lhr-solar/BPS-TestPCB/3d step files/11-PIHER_3D_PT10MH01.STEP

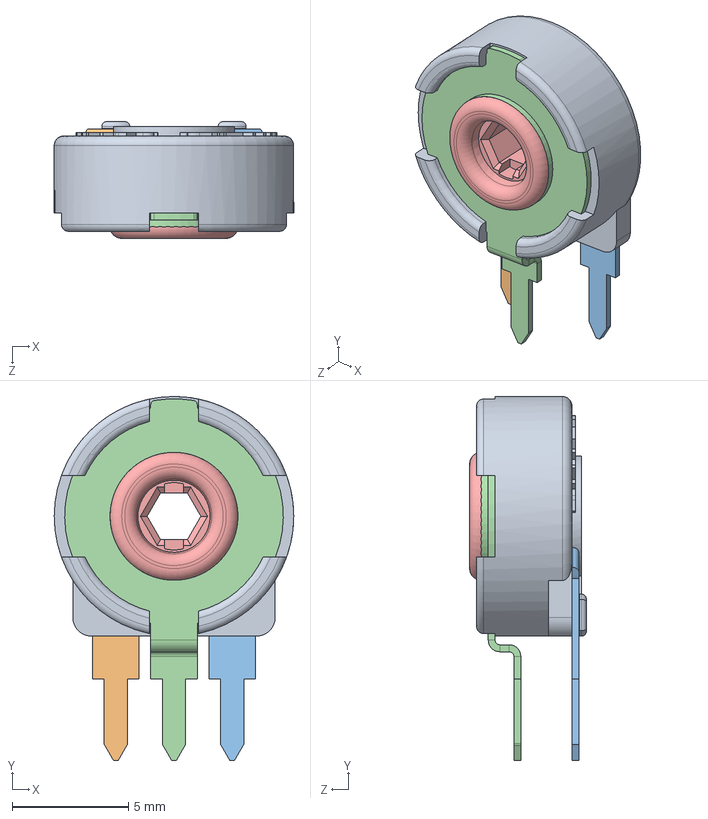
[picture p1: CAD file, 2021-10-09]
3d step files/11-PIHER_3D_PT10MH01.STEP
10.3 x 15.7 x 5.02 mm
PT10MH01-CARCASA
PT10MH01-TERMINAL DERECHO
PT10MH01-TERMINAL IZQUIERDO
PT10MH01-COLECTOR
PT10MH01-PORTACURSOR_Predeterminada
