lhr-solar/BPS-TestPCB/3d step files/10-PIHER_3D_PT10LV10.STEP

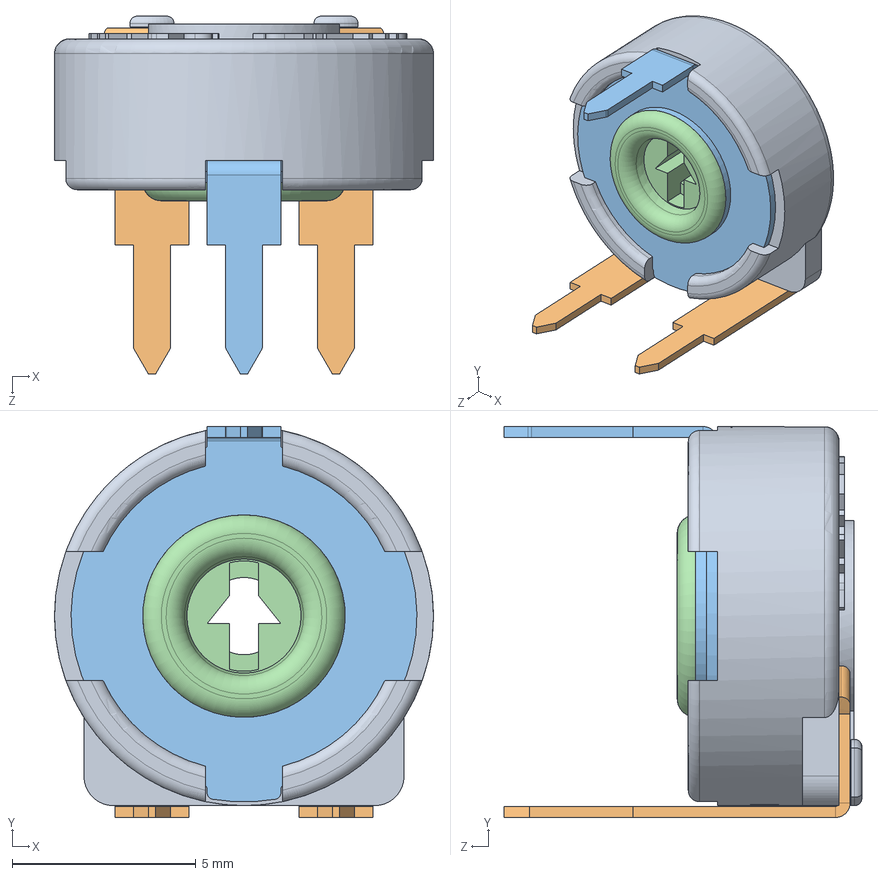
[picture p2: CAD file, 2021-10-09]
3d step files/10-PIHER_3D_PT10LV10.STEP
10.3 x 10.6 x 9.72 mm
PT10LV10-CARCASA
PT10LV10-TERMINAL DERECHO
PT10LV10-TERMINAL IZQUIERDO
PT10LV10-COLECTOR REBORDEADO
PT10LV10-PORTACURSOR_Predeterminada
