lhr-solar/BPS-TestPCB/3d step files/Banana_Receptacle.step

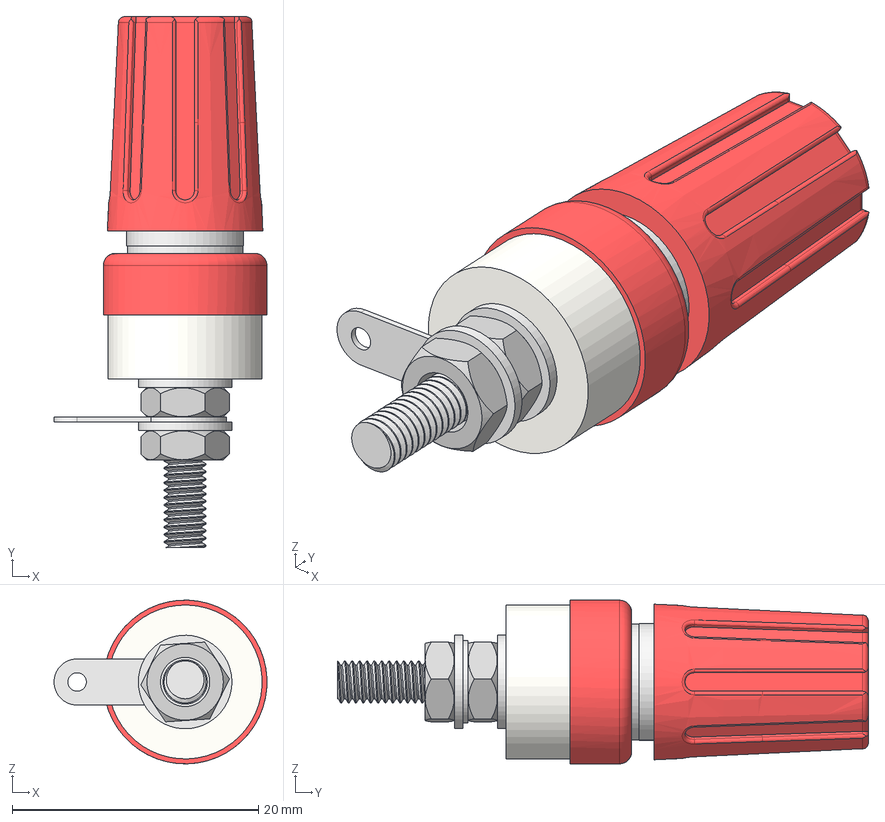
[picture p3: CAD file, 2021-10-09]
3d step files/Banana_Receptacle.step
17.3 x 43.1 x 13.3 mm
knob
external_spacer
teflon_spacer
washer x 2
nut x 2
solder_lug
knob_internal_contact
binding_post
