lhr-solar/BPS-TestPCB/3d step files/RFM-0505S_RCP.step

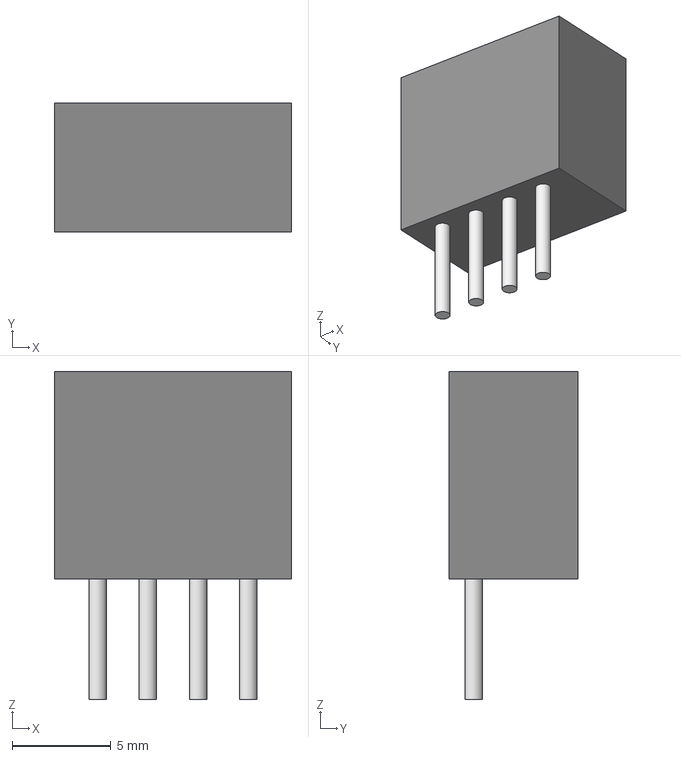
[picture p4: CAD file, 2021-10-09]
3d step files/RFM-0505S_RCP.step
12.0 x 6.50 x 16.6 mm
