lhr-solar/BPS-TestPCB/3d step files/12-PIHER_3D_PT10LH02.STEP

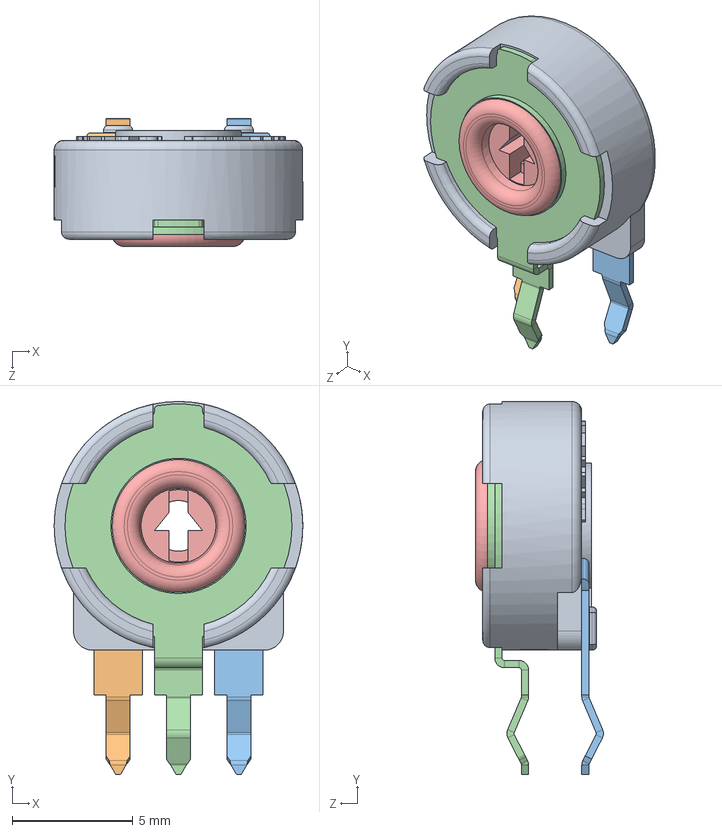
[picture p5: CAD file, 2021-10-09]
3d step files/12-PIHER_3D_PT10LH02.STEP
10.3 x 15.4 x 5.30 mm
PT10LH02-CARCASA
PT10LH02-TERMINAL DERECHO
PT10LH02-TERMINAL IZQUIERDO
PT10LH02-COLECTOR
PT10LH02-PORTACURSOR_Predeterminada
