lhr-solar/BPS-TestPCB/(list of files, cad)

Other CAD files:
3d step files/9-PIHER_3D_PT10MV10.STEP
