lhr-solar/BPS-TestPCB/BPS-Test.kicad_pcb

## KiCad design BPS-Test.kicad_pcb (2021-10-16)

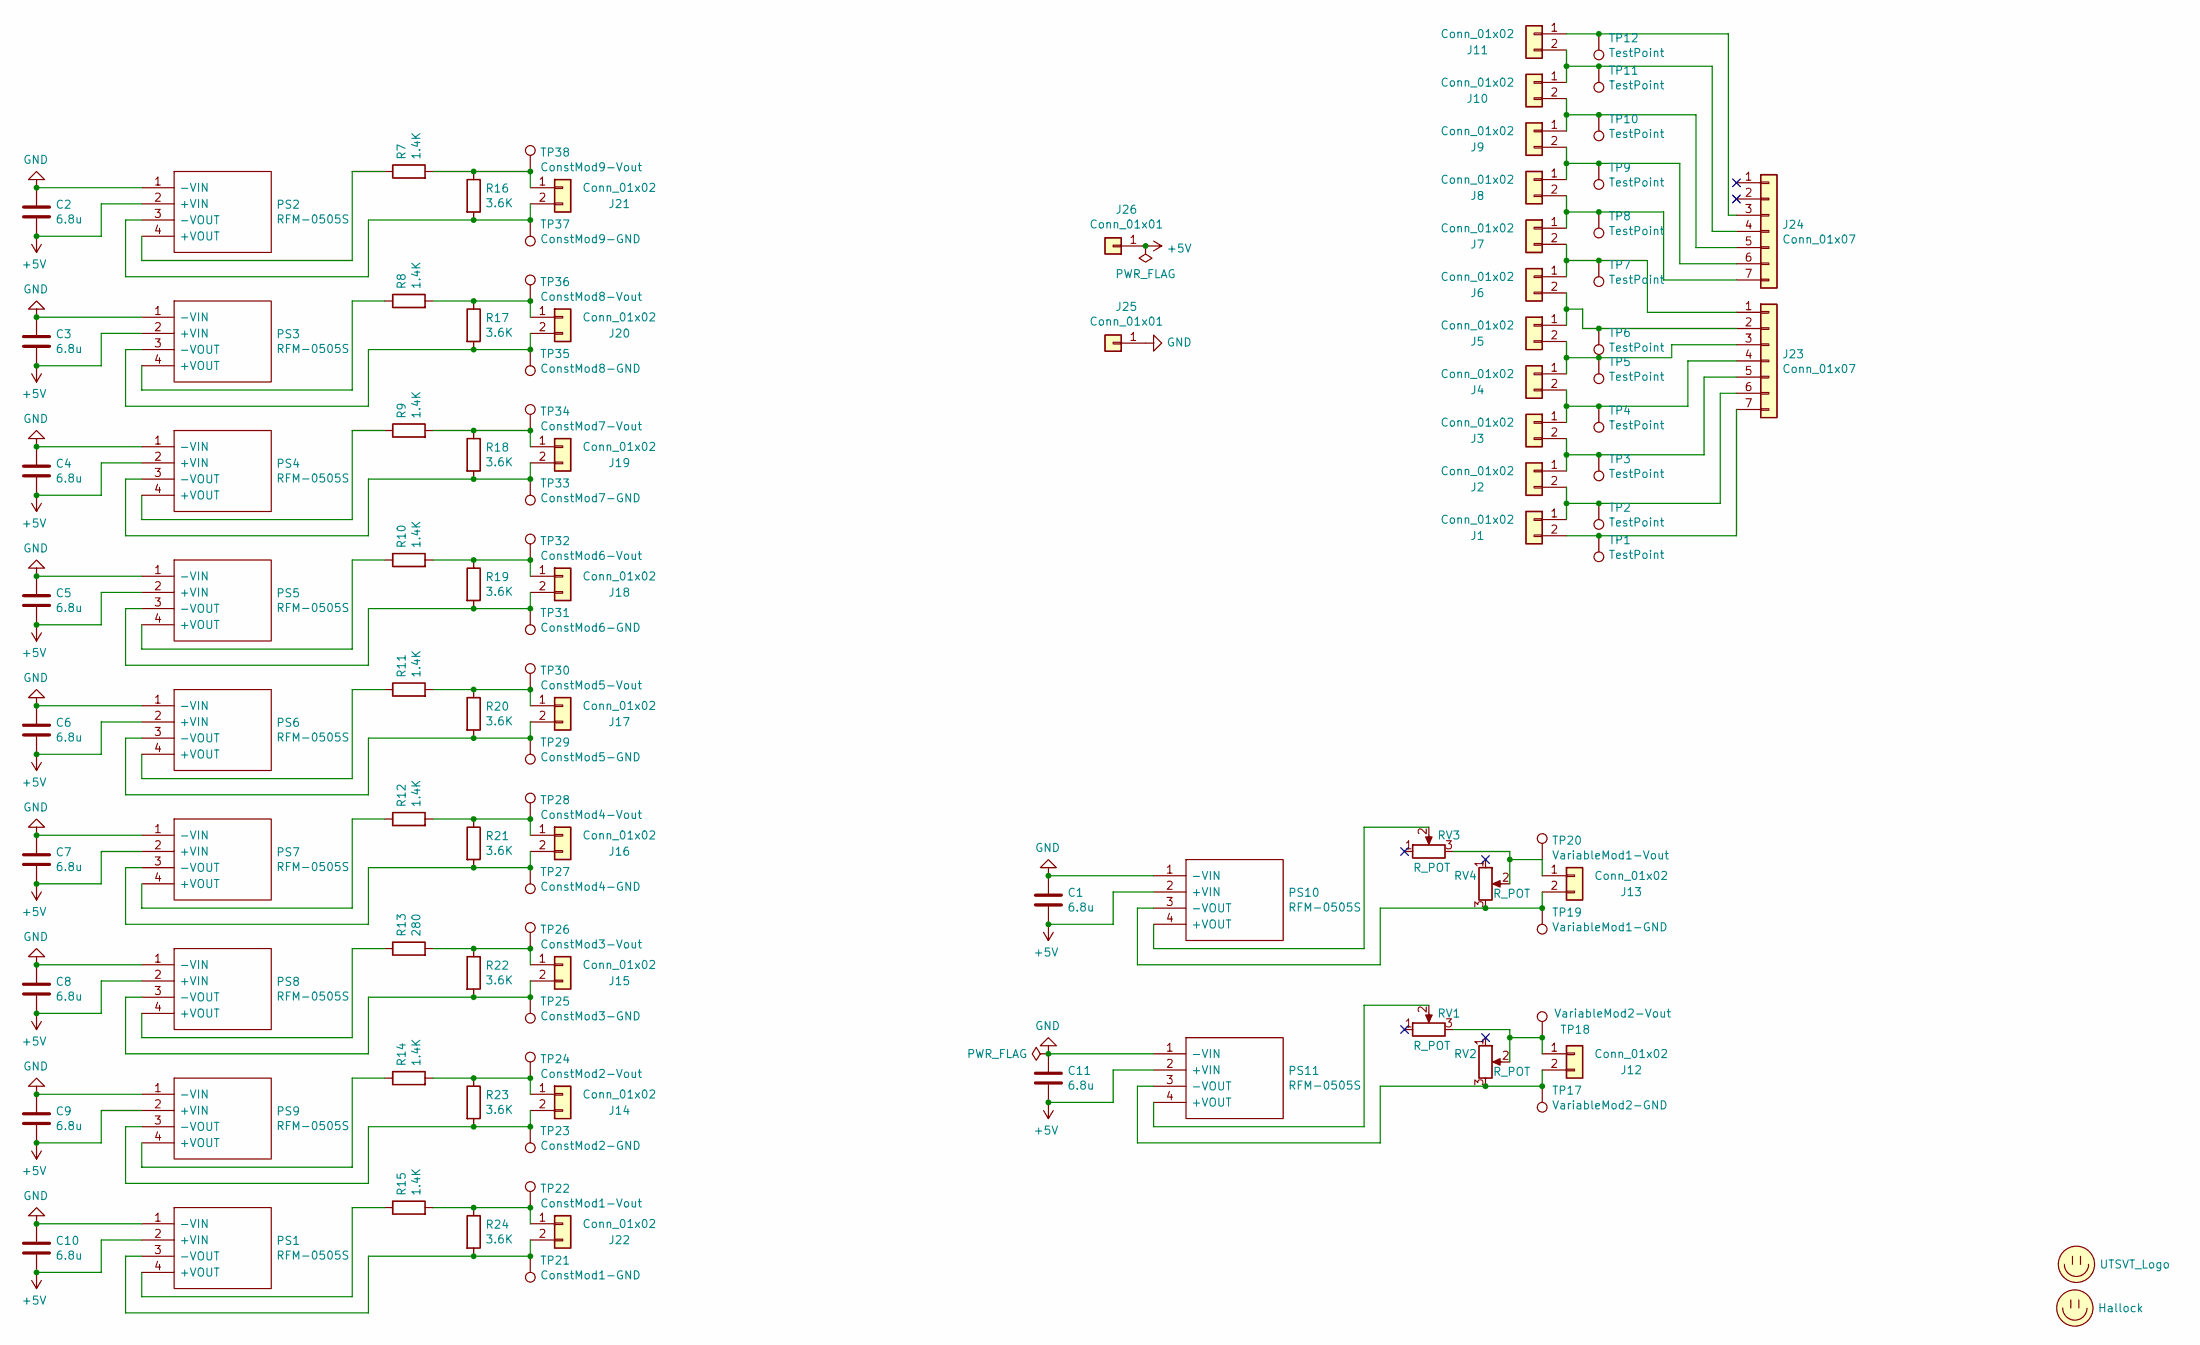
[picture p6: schematic BPS-Test.sch]

Parts:
C1, C2, C3, C4, C5, C6, C7, C8, C9, C10, C11: 6.8u; C_0805_2012Metric
J1, J2, J3, J4, J5, J6, J7, J8, J9, J10, J11, J12, J13, J14, J15, J16, J17, J18, J19, J20, J21, J22: Conn_01x02; PinHeader_1x02_P2.54mm_Vertical
J23, J24: Conn_01x07; Molex_MicroFit_01x07_Horizontal
J25, J26: Conn_01x01; Banana_Jack_1_Pin_4mm
LOGO1: Hallock; Hallock_Image
LOGO2: UTSVT_Logo; UTSVT_Logo_Symbol
PS1, PS2, PS3, PS4, PS5, PS6, PS7, PS8, PS9, PS10, PS11: RFM-0505S; RFM0505S; Mouser Part Number 919-RFM-0505S
R7, R8, R9, R10, R11, R12, R14, R15: 1.4K; R_0805_2012Metric
R13: 280; R_0805_2012Metric
R16, R17, R18, R19, R20, R21, R22, R23, R24: 3.6K; R_0805_2012Metric
RV1, RV2, RV3, RV4: R_POT; Potentiometer_Piher_PT-6-V_Vertical_Hole
TP1, TP2, TP3, TP4, TP5, TP6, TP7, TP8, TP9, TP10, TP11, TP12: TestPoint; TestPoint_Pad_2.0x2.0mm
TP17: VariableMod2-GND; TestPoint_Pad_2.0x2.0mm
TP18: VariableMod2-Vout; TestPoint_Pad_2.0x2.0mm
TP19: VariableMod1-GND; TestPoint_Pad_2.0x2.0mm
TP20: VariableMod1-Vout; TestPoint_Pad_2.0x2.0mm
TP21: ConstMod1-GND; TestPoint_Pad_2.0x2.0mm
TP22: ConstMod1-Vout; TestPoint_Pad_2.0x2.0mm
TP23: ConstMod2-GND; TestPoint_Pad_2.0x2.0mm
TP24: ConstMod2-Vout; TestPoint_Pad_2.0x2.0mm
TP25: ConstMod3-GND; TestPoint_Pad_2.0x2.0mm
TP26: ConstMod3-Vout; TestPoint_Pad_2.0x2.0mm
TP27: ConstMod4-GND; TestPoint_Pad_2.0x2.0mm
TP28: ConstMod4-Vout; TestPoint_Pad_2.0x2.0mm
TP29: ConstMod5-GND; TestPoint_Pad_2.0x2.0mm
TP30: ConstMod5-Vout; TestPoint_Pad_2.0x2.0mm
TP31: ConstMod6-GND; TestPoint_Pad_2.0x2.0mm
TP32: ConstMod6-Vout; TestPoint_Pad_2.0x2.0mm
TP33: ConstMod7-GND; TestPoint_Pad_2.0x2.0mm
TP34: ConstMod7-Vout; TestPoint_Pad_2.0x2.0mm
TP35: ConstMod8-GND; TestPoint_Pad_2.0x2.0mm
TP36: ConstMod8-Vout; TestPoint_Pad_2.0x2.0mm
TP37: ConstMod9-GND; TestPoint_Pad_2.0x2.0mm
TP38: ConstMod9-Vout; TestPoint_Pad_2.0x2.0mm

Connections:
+5V: C1.2, C2.2, C3.2, C4.2, C5.2, C6.2, C7.2, C8.2, C9.2, C10.2, C11.2, J26.1, PS1.2 (+VIN), PS2.2 (+VIN), PS3.2 (+VIN), PS4.2 (+VIN), PS5.2 (+VIN), PS6.2 (+VIN), PS7.2 (+VIN), PS8.2 (+VIN), PS9.2 (+VIN), PS10.2 (+VIN), PS11.2 (+VIN)
GND: C1.1, C2.1, C3.1, C4.1, C5.1, C6.1, C7.1, C8.1, C9.1, C10.1, C11.1, J25.1, PS1.1 (-VIN), PS2.1 (-VIN), PS3.1 (-VIN), PS4.1 (-VIN), PS5.1 (-VIN), PS6.1 (-VIN), PS7.1 (-VIN), PS8.1 (-VIN), PS9.1 (-VIN), PS10.1 (-VIN), PS11.1 (-VIN)
unnamed: J1.1, J2.2, J23.6, TP2.1
unnamed: J1.2, J23.7, TP1.1
unnamed: J2.1, J3.2, J23.5, TP3.1
unnamed: J10.1, J11.2, J24.4, TP11.1
unnamed: J9.1, J10.2, J24.5, TP10.1
unnamed: J11.1, J24.3, TP12.1
unnamed: J12.1, RV1.3, RV2.2, TP18.1
unnamed: J12.2, PS11.3 (-VOUT), RV2.3, TP17.1
unnamed: J13.1, RV3.3, RV4.2, TP20.1
unnamed: J13.2, PS10.3 (-VOUT), RV4.3, TP19.1
unnamed: J14.1, R14.2, R23.1, TP24.1
unnamed: J14.2, PS9.3 (-VOUT), R23.2, TP23.1
unnamed: J15.1, R13.2, R22.1, TP26.1
unnamed: J15.2, PS8.3 (-VOUT), R22.2, TP25.1
unnamed: J16.1, R12.2, R21.1, TP28.1
unnamed: J16.2, PS7.3 (-VOUT), R21.2, TP27.1
unnamed: J17.1, R11.2, R20.1, TP30.1
unnamed: J17.2, PS6.3 (-VOUT), R20.2, TP29.1
unnamed: J18.1, R10.2, R19.1, TP32.1
unnamed: J18.2, PS5.3 (-VOUT), R19.2, TP31.1
unnamed: J19.1, R9.2, R18.1, TP34.1
unnamed: J19.2, PS4.3 (-VOUT), R18.2, TP33.1
unnamed: J20.1, R8.2, R17.1, TP36.1
unnamed: J20.2, PS3.3 (-VOUT), R17.2, TP35.1
unnamed: J21.1, R7.2, R16.1, TP38.1
unnamed: J21.2, PS2.3 (-VOUT), R16.2, TP37.1
unnamed: J22.1, R15.2, R24.1, TP22.1
unnamed: J22.2, PS1.3 (-VOUT), R24.2, TP21.1
unnamed: J6.1, J7.2, J23.1, TP7.1
unnamed: J5.1, J6.2, J23.2, TP6.1
unnamed: J4.1, J5.2, J23.3, TP5.1
unnamed: J3.1, J4.2, J23.4, TP4.1
unnamed: J8.1, J9.2, J24.6, TP9.1
unnamed: J7.1, J8.2, J24.7, TP8.1
unnamed: PS1.4 (+VOUT), R15.1
unnamed: PS2.4 (+VOUT), R7.1
unnamed: PS3.4 (+VOUT), R8.1
unnamed: PS4.4 (+VOUT), R9.1
unnamed: PS5.4 (+VOUT), R10.1
unnamed: PS6.4 (+VOUT), R11.1
unnamed: PS7.4 (+VOUT), R12.1
unnamed: PS8.4 (+VOUT), R13.1
unnamed: PS9.4 (+VOUT), R14.1
unnamed: PS10.4 (+VOUT), RV3.2
unnamed: PS11.4 (+VOUT), RV1.2

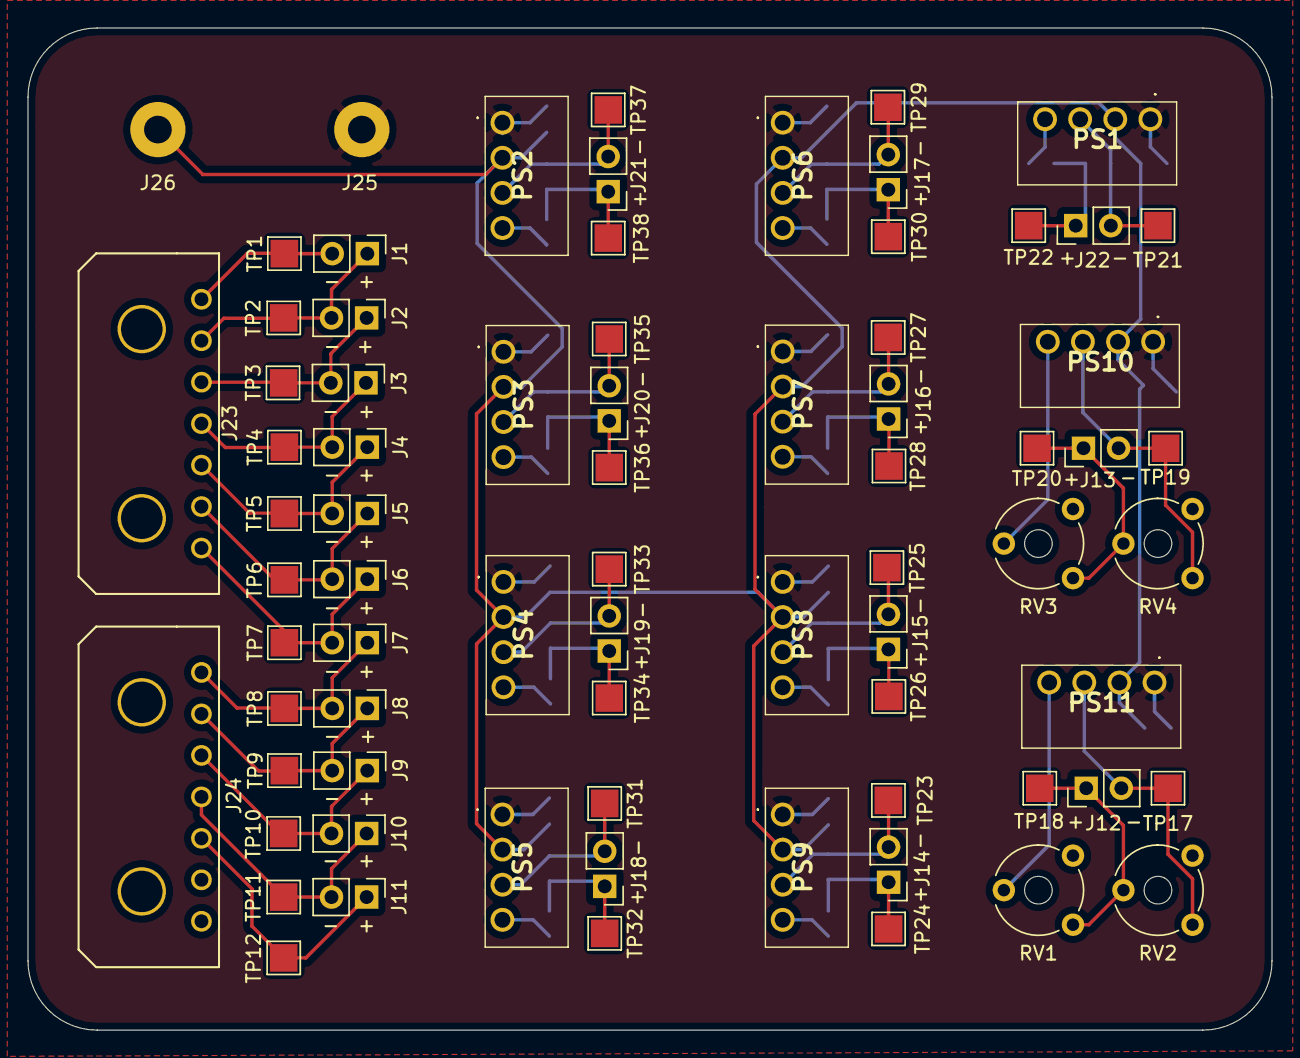
[picture p7: board BPS-Test.kicad_pcb from above]

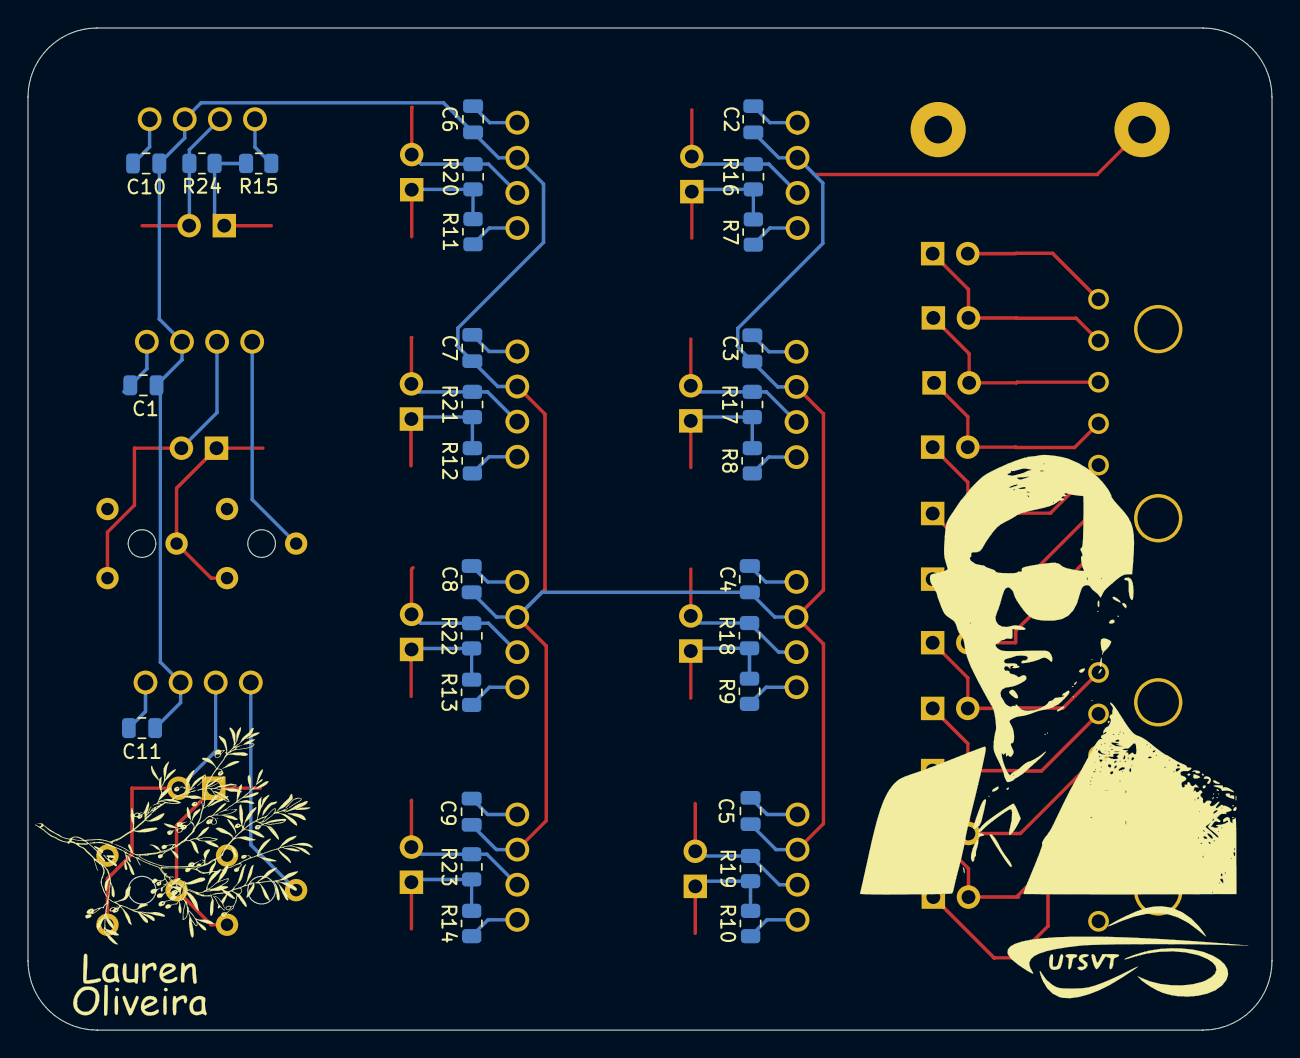
[picture p8: board BPS-Test.kicad_pcb from below]

Board: 2 copper layers, 90.0 x 72.5 mm, 106 parts (31 on the bottom side), 47 nets.
