lhr-solar/BPS-TestPCB/TestBoard.kicad_pcb

## KiCad design TestBoard.kicad_pcb (2021-10-09)

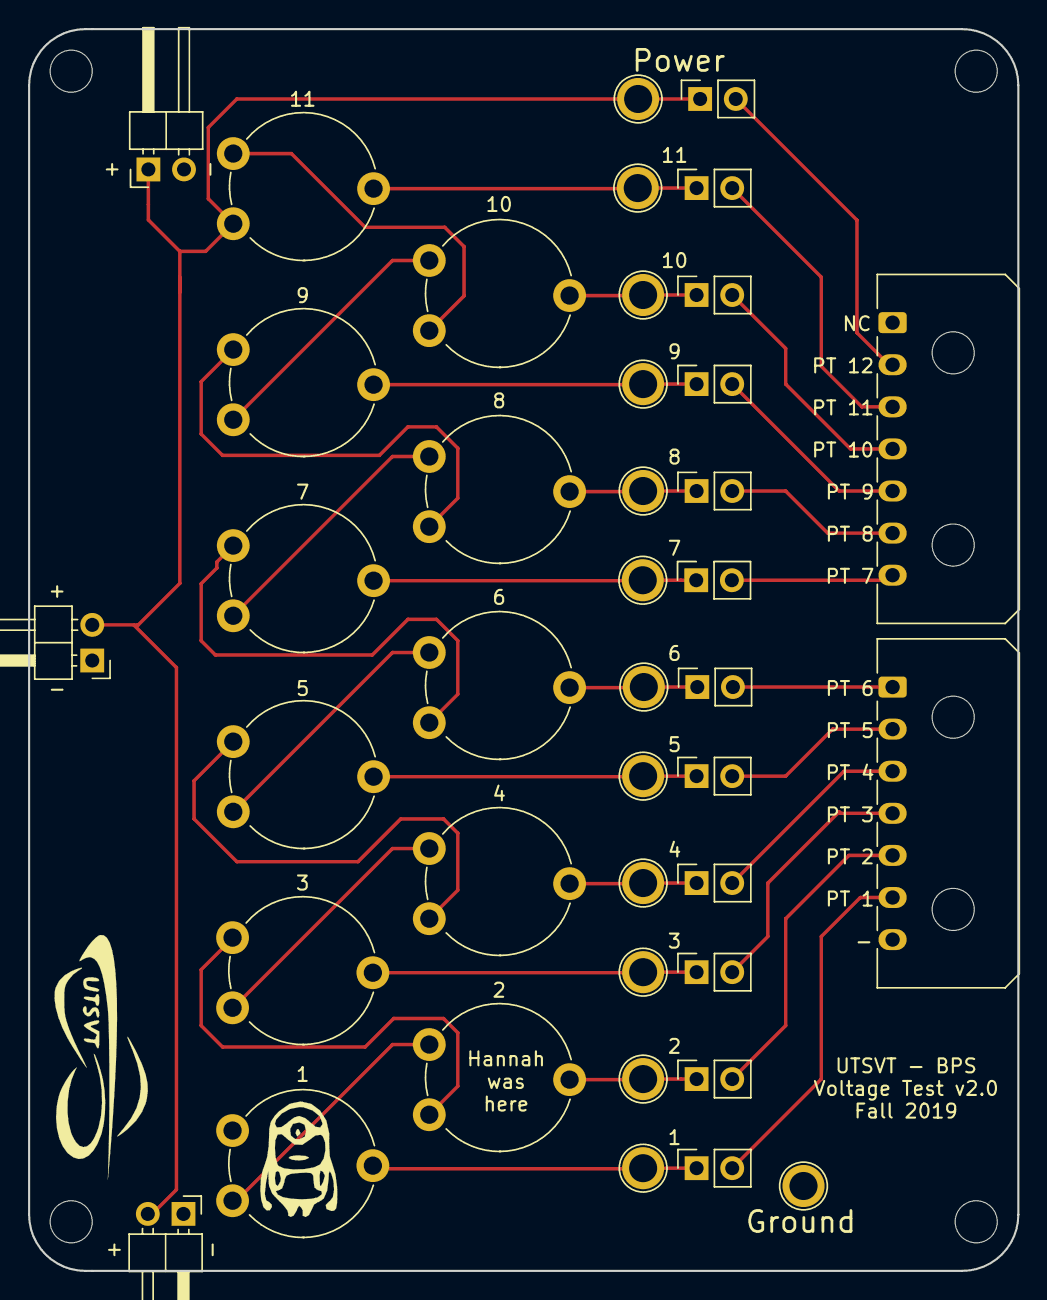
[picture p9: board TestBoard.kicad_pcb from above]

Board: 2 copper layers, 70.5 x 88.5 mm, 45 parts (0 on the bottom side), 35 nets.

Parts:
H1, H2, H3, H4: MountingHole; MountingHole_3mm
J1, J4, J5: Conn_01x02; PinHeader_1x02_P2.54mm_Horizontal
J2, J3: Conn_01x07; Molex_Micro-Fit_3.0_43650-0700_1x07_P3.00mm_Horizontal
JP1, JP2, JP3, JP4, JP5, JP6, JP7, JP8, JP9, JP10, JP11, JP12: Jumper; PinSocket_1x02_P2.54mm_Vertical
RV1, RV2, RV3, RV4, RV5, RV6, RV7, RV8, RV9, RV10, RV11: R_POT; Potentiometer_Piher_PT-10-V10_Vertical
TP1, TP2, TP3, TP4, TP5, TP6, TP7, TP8, TP9, TP10, TP11, TP12, TP13: TestPoint; TestPoint_Plated_Hole_D2.0mm

Connections:
+36V: J1.2, J4.1, J5.2, JP12.1, RV1.1, TP12.1
GND: J1.1, J3.7, J4.2, J5.1, RV11.3, TP13.1
unnamed: J2.2, JP12.2
unnamed: J2.3, JP1.2
unnamed: J2.4, JP2.2
unnamed: J2.5, JP3.2
unnamed: J2.6, JP4.2
unnamed: J2.7, JP5.2
unnamed: J3.1, JP6.2
unnamed: J3.2, JP7.2
unnamed: J3.3, JP8.2
unnamed: J3.4, JP9.2
unnamed: J3.5, JP10.2
unnamed: J3.6, JP11.2
unnamed: JP1.1, RV1.2, TP1.1
unnamed: JP2.1, RV2.2, TP2.1
unnamed: JP3.1, RV3.2, TP3.1
unnamed: JP4.1, RV4.2, TP4.1
unnamed: JP5.1, RV5.2, TP5.1
unnamed: JP6.1, RV6.2, TP6.1
unnamed: JP7.1, RV7.2, TP7.1
unnamed: JP8.1, RV8.2, TP8.1
unnamed: JP9.1, RV9.2, TP9.1
unnamed: JP10.1, RV10.2, TP10.1
unnamed: JP11.1, RV11.2, TP11.1
unnamed: RV1.3, RV2.1
unnamed: RV2.3, RV3.1
unnamed: RV3.3, RV4.1
unnamed: RV4.3, RV5.1
unnamed: RV5.3, RV6.1
unnamed: RV6.3, RV7.1
unnamed: RV7.3, RV8.1
unnamed: RV8.3, RV9.1
unnamed: RV9.3, RV10.1
unnamed: RV10.3, RV11.1
