lhr-solar/BPS-TestPCB/(commit log)

2020-08-02 Set up for own repo
    [BOM.csv, BPS-Nucleo.kicad_pcb, BPS-Nucleo.sch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]
2021-10-09 Updates master with the most recent version
    [10-PIHER_3D_PT10LV10.STEP, 11-PIHER_3D_PT10MH01.STEP, 12-PIHER_3D_PT10LH02.STEP, 9-PIHER_3D_PT10MV10.STEP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]
2021-10-16 Complete redesign of BPS Test board
    [BPS-Test.kicad_pcb]
